Maiiialen/Project-of-medications-dispending-robot/electrical_diagram/RobotDoWydawaniaMedykamentow.pdf

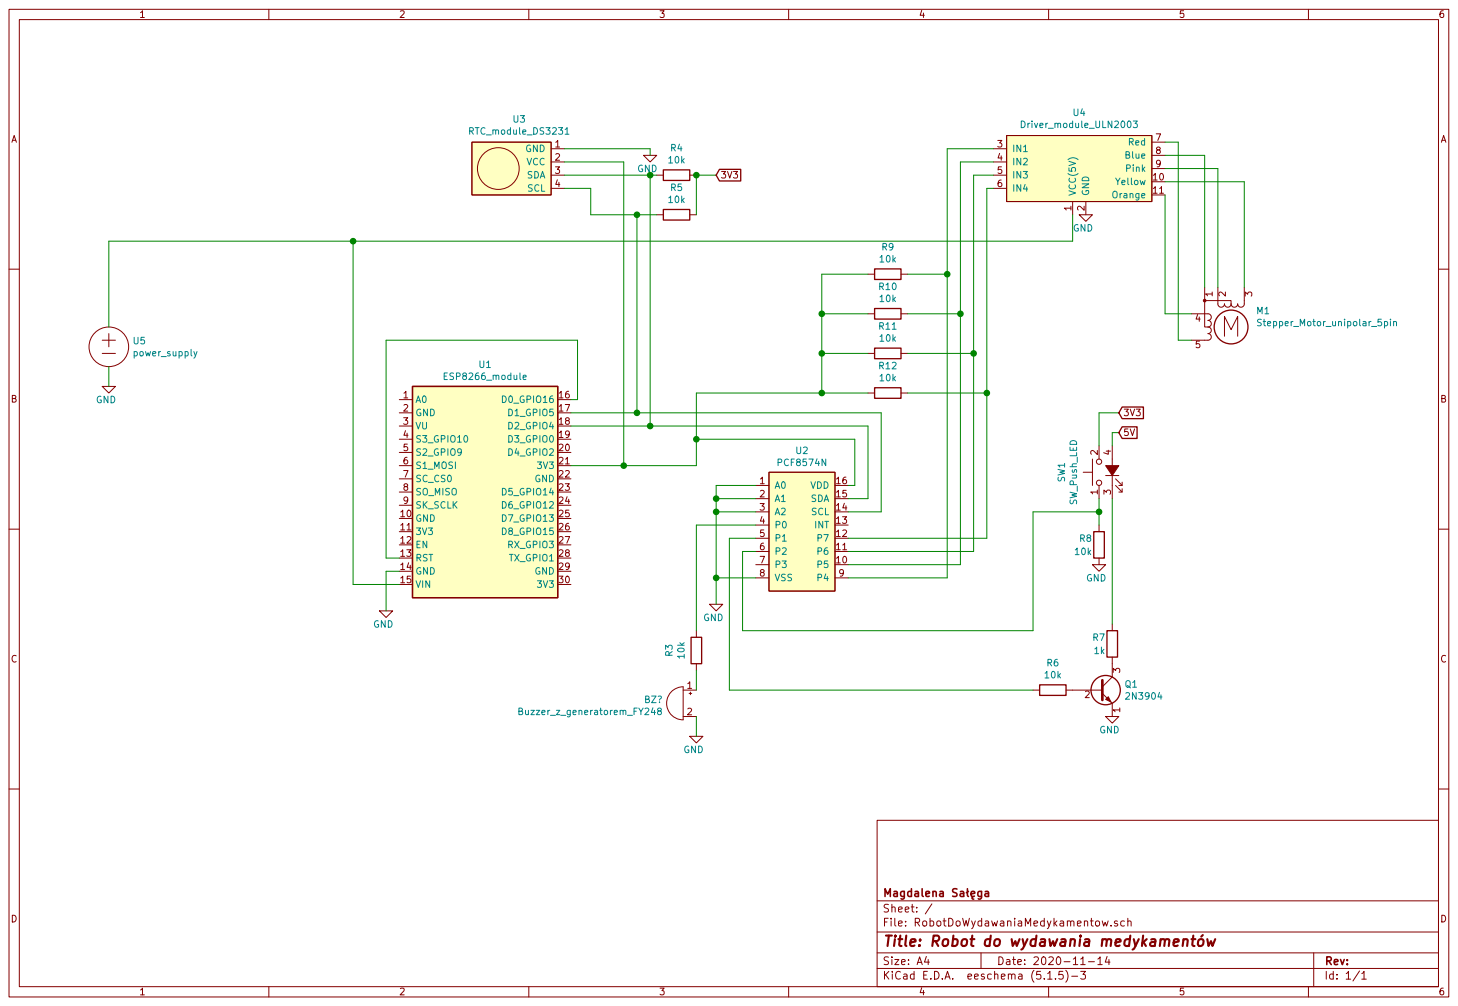
[picture p5: page 1]

Id: 1/1 Title: Robot do wydawania medykamentów
