Maiiialen/Project-of-medications-dispending-robot/electrical_diagram/RobotDoWydawaniaMedykamentow.sch

## KiCad design electrical_diagram/RobotDoWydawaniaMedykamentow.sch (2021-04-21)

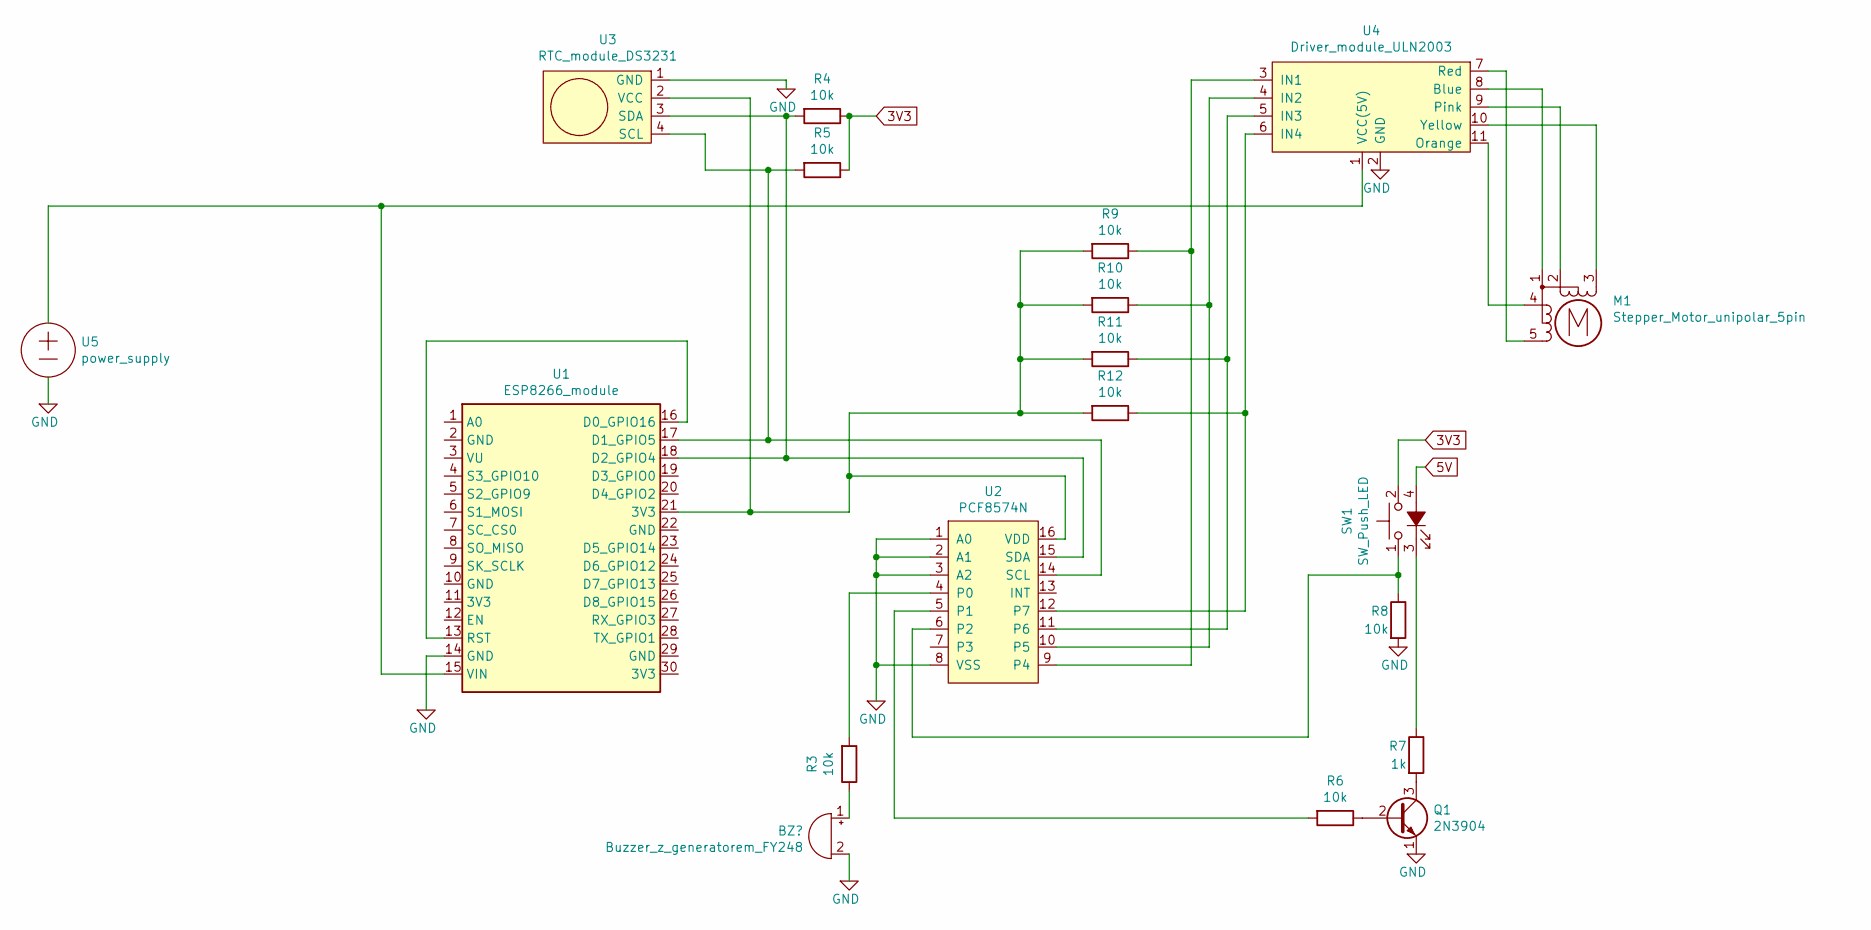
[picture p6: schematic RobotDoWydawaniaMedykamentow.sch]

Parts:
GND: 0
M1: Stepper_Motor_unipolar_5pin
Q1: 2N3904; TO-92_Inline
R3, R4, R5, R6, R8, R9, R10, R11, R12: 10k
R7: 1k
SW1: SW_Push_LED
U1: ESP8266_module; ESP-12E
U2: PCF8574N
U3: RTC_module_DS3231
U4: Driver_module_ULN2003
U5: power_supply

Connections:
3V3: R4.1, R5.1, SW1.2
5V: SW1.4 (A)
unnamed: GND.1, Q1.1 (E), R8.2, U1.14 (GND), U2.1 (A0), U2.2 (A1), U2.3 (A2), U2.8 (VSS), U3.1 (GND), U4.2 (GND), U5.0
unnamed: M1.1, U4.8 (Blue)
unnamed: M1.2, U4.9 (Pink)
unnamed: M1.3 (-), U4.10 (Yellow)
unnamed: M1.4, U4.11 (Orange)
unnamed: M1.5, U4.7 (Red)
unnamed: Q1.2 (B), R6.1
unnamed: Q1.3 (C), R7.2
unnamed: R3.2, U2.4 (P0)
unnamed: R4.2, U1.18 (D2_GPIO4), U2.15 (SDA), U3.3 (SDA)
unnamed: R5.2, U1.17 (D1_GPIO5), U2.14 (SCL), U3.4 (SCL)
unnamed: R6.2, U2.5 (P1)
unnamed: R7.1, SW1.3 (K)
unnamed: R8.1, SW1.1, U2.6 (P2)
unnamed: R9.1, U2.9 (P4), U4.3 (IN1)
unnamed: R10.1, U2.10 (P5), U4.4 (IN2)
unnamed: R9.2, R10.2, R11.2, R12.2, U1.21 (3V3), U2.16 (VDD), U3.2 (VCC)
unnamed: R11.1, U2.11 (P6), U4.5 (IN3)
unnamed: R12.1, U2.12 (P7), U4.6 (IN4)
unnamed: U1.13 (RST), U1.16 (D0_GPIO16)
unnamed: U1.15 (VIN), U4.1 (VCC(5V)), U5.0
