Maiiialen/Project-of-medications-dispending-robot/(commit log)

2020-10-27 początkowe wersje oprogramowania ESP oraz schemat elektryczny
    [RobotDoLekow.kicad_pcb, RobotDoLekow.sch]
2020-11-02 dodawanie ekspandera
    [RobotDoLekow.sch]
2020-11-12 poprawienie aplikacji mobilnej i rozwijanie kodu do esp8266
    [RobotDoLekow.sch]
2020-11-19 poprawienie pobierania nastepnego alarmu oraz nazewnictwa liczbowego
    [RobotDoLekow.sch]
2020-12-02 wersja końcowa
    [RobotDoLekow.sch]
2021-04-21 reorganizacja plików
    Uporządkowywanie projektu (krok 1)
    [RobotDoLekow.kicad_pcb, RobotDoLekow.sch, RobotDoWydawaniaMedykamentow.sch]
